Andrerizm/IoTMaintenanceDWD/dashboard/assets/hero-bg.png

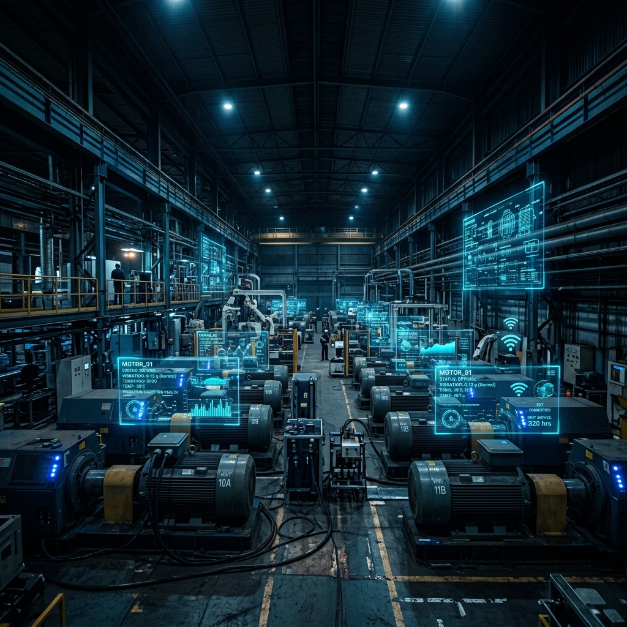
dashboard/assets/hero-bg.png
