Andrerizm/IoTMaintenanceDWD/Flowchart.png

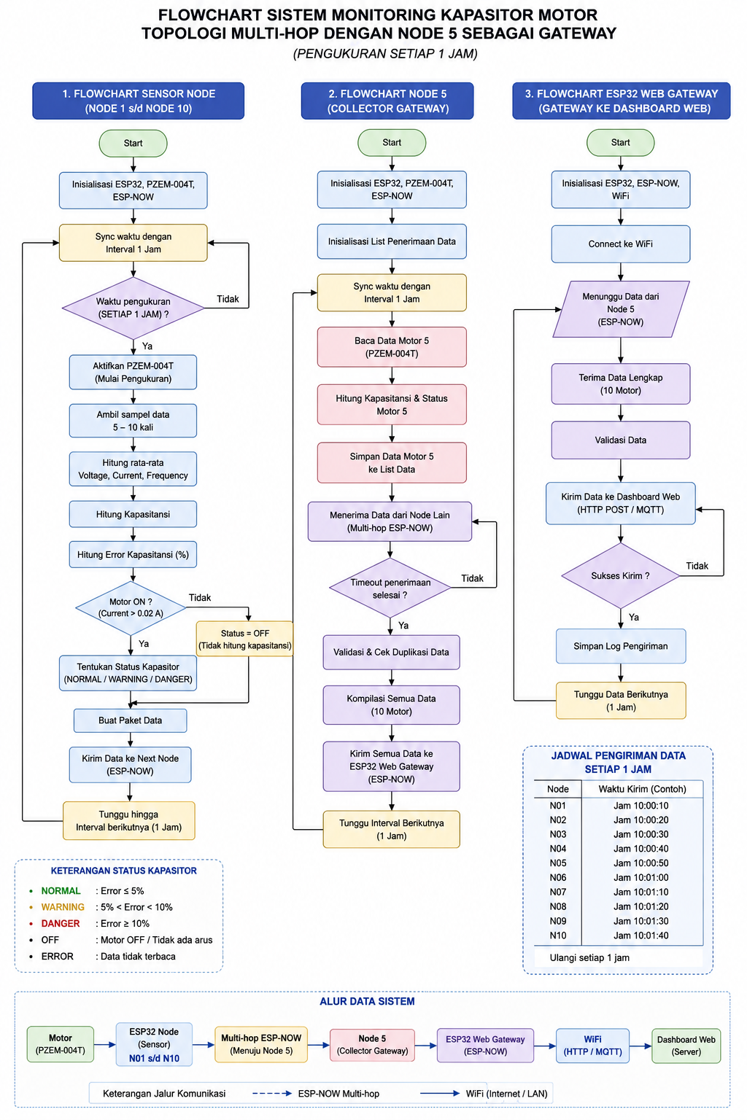
Flowchart.png
