Andrerizm/IoTMaintenanceDWD/PPT/Perbandingan Wireless dan Wired Pada Monitoring Kapasitor.pptx

## Perbandingan Topologi Wired vs Wireless

- Komparasi Arsitektur | Wired RS485 vs Wireless ESP-NOW

- Andre Rizkyna Muharam

- Sistem Monitoring Kapasitansi Kapasitor Motor

## Slide 2

IN THIS REPORT

Latar Belakang

- Efisiensi biaya sistem monitoring
- Kondisi mesin memanjang

Opsi Wired

- 1 ESP32 pusat
- 10 PZEM melalui bus RS485

Opsi Wireless

- 10 ESP32 node untuk 10 motor
- ESP-NOW / WiFi lokal

Perbandingan

- Komponen, biaya, stabilitas
- Risiko dan maintenance

Rekomendasi

Untuk mesin memanjang dan efisiensi biaya, opsi wired RS485 lebih disarankan.

2

## Slide 3

KONFIGURASI YANG
DIBANDINGKAN

3

## Slide 4

OPSI 1: WIRELESS

- 1 motor = 1 PZEM + 1 ESP32.
- Setiap node mengirim data melalui ESP-NOW/WiFi.
- Kabel komunikasi antar motor tidak diperlukan.
- Cocok jika penarikan kabel sangat sulit.

OPSI 2: WIRED RS485

- 10 PZEM dihubungkan ke 1 ESP32 pusat melalui bus RS485.
- Setiap PZEM diberi alamat berbeda.
- Topologi daisy-chain mengikuti mesin memanjang.
- ESP32 pusat mengirim data ke dashboard.

Fokus Keputusan

Biaya & Stabilitas

4

## Slide 5

METODOLOGI PENGUKURAN KAPASITANSI

3

## Slide 6

PRINSIP PERHITUNGAN

CONTOH UNTUK 2 UF / 220 VAC

I = 2 pi x 50 x 2e-6 x 220
I ≈ 0,138 A

- Karena arus kapasitor kecil, sensor arus harus memiliki range kecil dan resolusi cukup.
- CT harus dipasang pada satu kabel kapasitor, bukan kabel utama motor.
- Voltage transducer membaca terminal kapasitor, bukan hanya sumber utama.

C = I / (2 pi x f x V)

- I = arus RMS pada jalur kapasitor dari CT clamp.
- V = tegangan RMS pada terminal kapasitor dari voltage transducer.
- f = frekuensi listrik, digunakan 50 Hz.
- Hasil C dikonversi ke mikrofarad untuk dashboard.

Kapasitor
2 uF

CT Clamp
I RMS

Voltage
Transducer

ESP32
Hitung C

Dashboard

6

## Slide 7

PERBANDINGAN KOMPONEN
PER MESIN

5

## Slide 8

RINGKASAN PERBANDINGAN

Aspek | Wireless | Wired RS485
ESP32 per mesin | 10 pcs | 1 pcs
Komunikasi | ESP-NOW/WiFi antar node | RS485 daisy-chain
Power Supply | Satu PSU per node | Satu PSU 5V 5A untuk semua node
Instalasi | Lebih mudah karena sedikit kabel | Lebih banyak pemasangan kabel
Perawatan | Setiap node berdiri sendiri | Pemeriksaan bus dan koneksi terminal
Resiko gangguan | Sinyal wireless dapat terhalang struktur mesin dan mengganggu jaringan mesh | Kabel dapat putus atau koneksi terminal longgar
Paling cocok | Lokasi sulit dijangkau kabel | Mesin memanjang dan membutuhkan komunikasi yang stabil
Stabilitas Komunikasi | Dipengaruhi jarak, penghalang, dan interfensi | Lebih stabil pada lingkungan industry
Harga | Rp4.496.750 - Rp5.053.750 | Rp1.478.139 – Rp1.674.139

RS485

11 conv.

10 sisi PZEM + 1 sisi controller.

Wired

1 ESP32

Satu controller pusat membaca 10 PZEM.

Wireless

10 ESP32

Satu node mandiri untuk setiap motor.

Skala

30 mesin

Wired mengurangi ESP32 dari 300 menjadi 30 unit.

6

## Slide 9

PERBANDINGAN TEKNIS

7

## Slide 10

WIRELESS

WIRED RS485

10 node ESP32

- Koneksi komunikasi antar motor tidak memakai kabel.
- Setiap titik membutuhkan ESP32, power, box, dan konfigurasi node.
- Dipengaruhi posisi antena, panel logam, dan noise 2,4 GHz.

1 controller pusat + bus data

- Lebih stabil untuk mesin memanjang.
- Biaya controller lebih rendah.
- Perlu kabel twisted pair, terminasi, alamat PZEM, dan proteksi jalur.

PZEM
Motor

TTL-RS485
Node

RS485
Bus

ESP32
Pusat

Dashboard
Web

8

## Slide 11

ANALISIS RISIKO
DAN MITIGASI

9

## Slide 12

1
Power
5 V

2
Jarak
Mesin

3
Noise
Motor

4
Alamat
PZEM

5
Bus
RS485

6
Data ke
Dashboard

RISIKO OPSI WIRELESS

- Sinyal ESP-NOW dapat terganggu panel logam.
- Setiap motor membutuhkan ESP32 dan supply sendiri.
- Konfigurasi node lebih banyak.
- Troubleshooting tersebar di 10 titik.
- Rawan mengganggu sinyal komunikasi lain

RISIKO OPSI WIRED

- Kabel bus harus ditarik sepanjang mesin.
- Jika bus putus, node setelah titik putus dapat terganggu (bisa diakali dengan mengubah system pengkabelan).
- Perlu terminasi 120 ohm di dua ujung dan alamat unik.
- Distribusi 5 V harus memperhatikan drop tegangan.

10

## Slide 13

WIRING DIAGRAM

9

## Slide 14

WIRELESS

9

## Slide 15

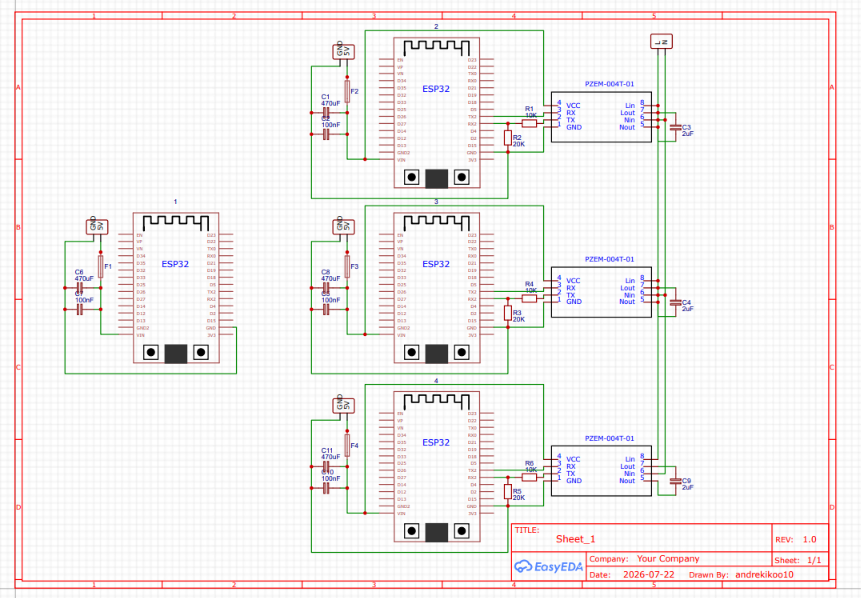
[picture p6: figure]

## Slide 16

WIRED

9

## Slide 17

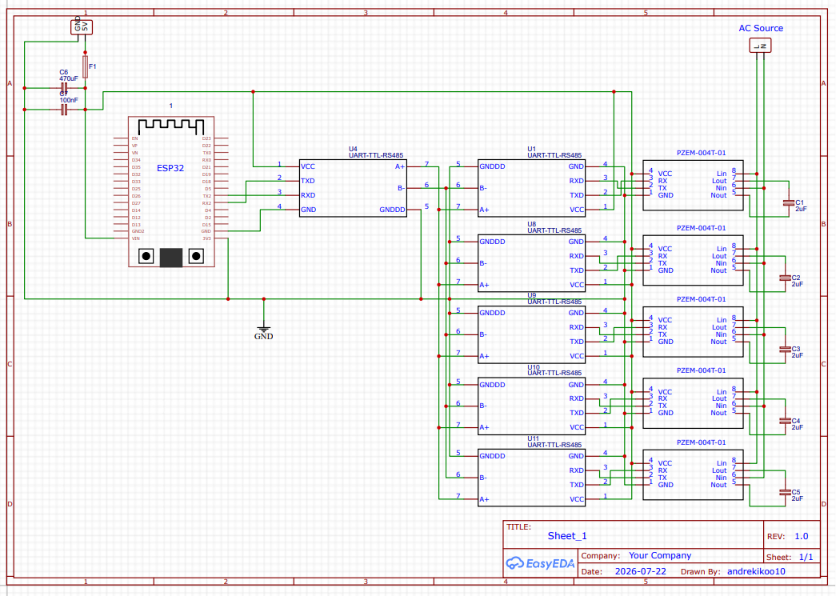
[picture p7: figure]

## Slide 18

REKOMENDASI
AKHIR

11

## Slide 19

Titik Motor

Motor 01 - 30
Kapasitor

Node Meter

PZEM-004T
Alamat 0x01

Bus Komunikasi

Dashboard

Dashboard
Historis

TTL-RS485
Auto Direction

ESP32 Pusat
Polling 1 Jam

REKOMENDASI

Menggunakan wired RS485 sebagai backbone pada mesin memanjang, lalu menggunakan wireless hanya dari ESP32 pusat ke dashboard/server. Opsi ini menekan biaya ESP32, lebih stabil terhadap panel logam, dan tetap mendukung data historis setiap motor.

12

## Slide 20

DASHBOARD WEB MONITORING

3

## Slide 21

TAMPILAN GRID 30 MESIN

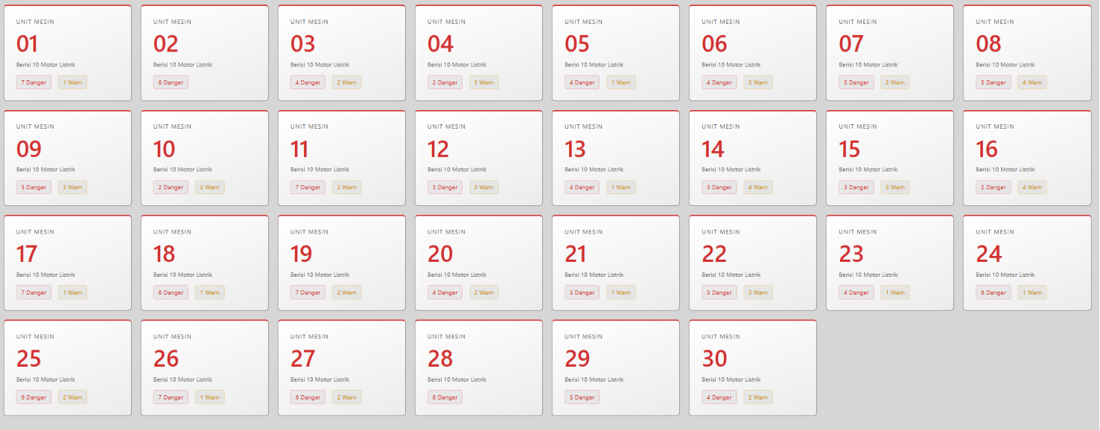
[picture p8: figure]

10

## Slide 22

SAAT KOTAK MESIN DITEKAN

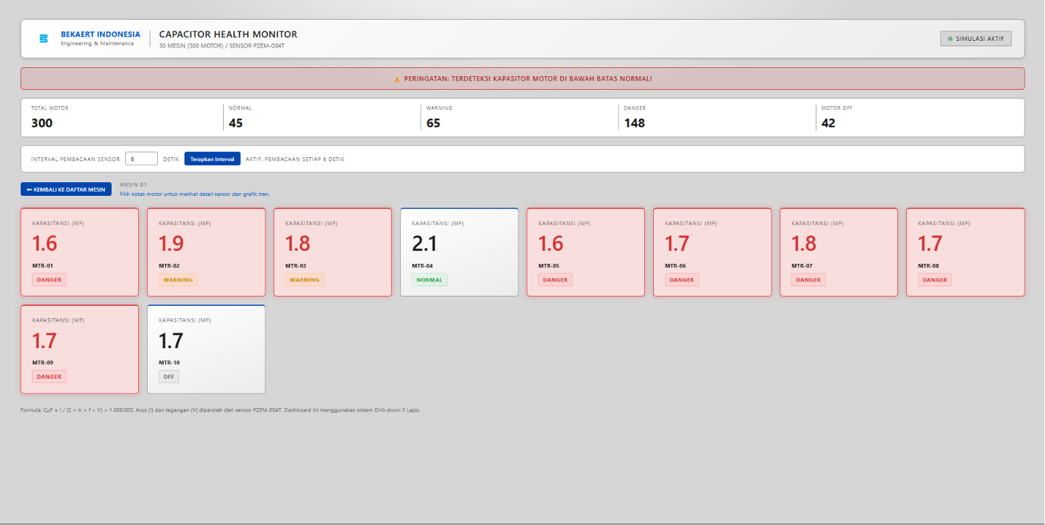
[picture p9: figure]

11

## Slide 23

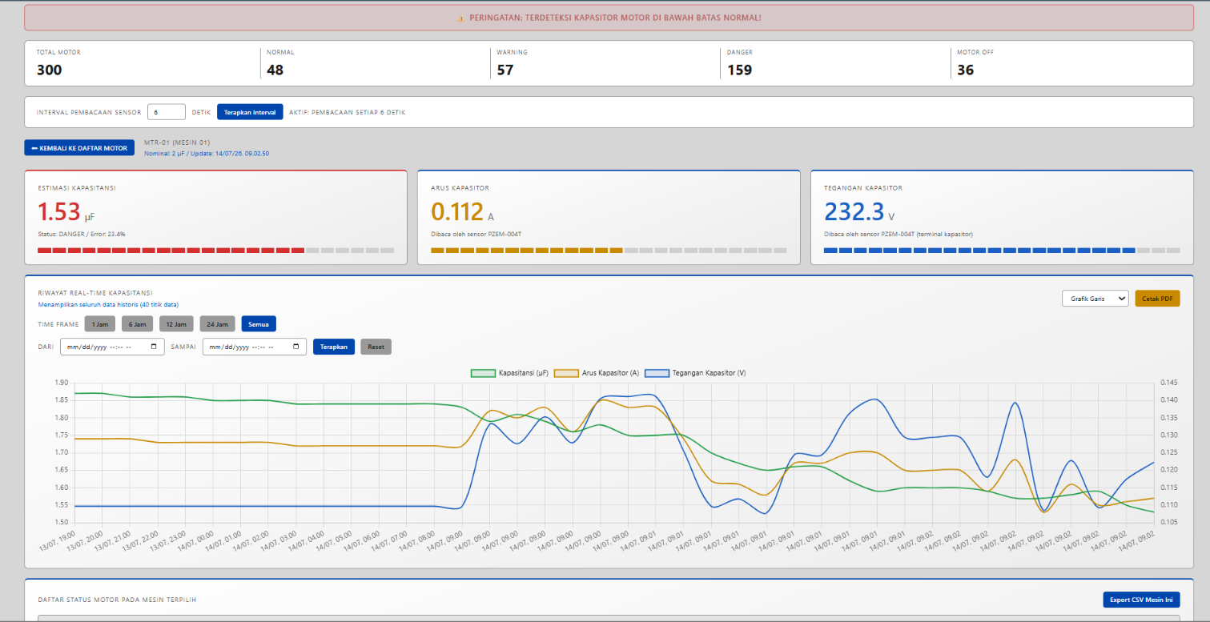
[picture p10: figure]

SAAT KOTAK MOTOR DITEKAN

12

## Slide 24

PERBANDINGAN HARGA DAN KOMPONEN YANG DIGUNAKAN

9

## Slide 25

WIRELESS

9

## Slide 26

WIRELESS

No | Komponen | Fungsi | Kuantitas | Harga Satuan | Total Harga | Link
1 | ESP32 DevKit V1 | Controller utama, hitung C, kirim data dashboard | 10 pcs | Rp63.000 – Rp100.000 | Rp630.000 - Rp1000.000 | Produk (https://www.tokopedia.com/rajaduino/esp32-esp-32-devkit-v1-board-30-pin-wifi-bluetooth-ble-microcontroller-cp2102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)
2 | PZEM-004T 10A | Membaca arus, tegangan, frekuensi, power factor, dan daya tiap kapasitor | 10 pcs | Rp65.000 - Rp80.000 | Rp650.000 - Rp800.000 | Produk (https://www.tokopedia.com/automa88/pzem-004t-10a-multifunction-ac-220v-volt-ampere-energy-meter-10a-ttl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)
3 | ESP32 Web Gateway | Diperlukan jika gateway web dipisahkan | 1 pcs | Rp63.000 – Rp100.000 | Rp63.000 – Rp100.000 | Produk (https://www.tokopedia.com/rajaduino/esp32-esp-32-devkit-v1-board-30-pin-wifi-bluetooth-ble-microcontroller-cp2102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)
4 | PCB matrix | Pengaman tata letak komponen di titik | 11 pcs | Rp15.000 | Rp150.000 | Produk (https://shopee.co.id/PCB-Dot-Matrix-Thru-Hole-Single-Layer-9x15-cm-%E2%80%93-Papan-Prototyping-Elektronik-i.62956347.5413059604)
5 | Box | Sebagai pengaman kompoen dan PCB | 11 pcs | Rp12.000 | Rp132.000 | Produk (https://shopee.co.id/BOX-MULTI-BOX-PLASTIK-SERBAGUNA-BOX-PROJEK-X1-X2-X3-X4-X5-X6-BELUM-TERMASUK-BAUT-i.395114462.25014973652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)
6 | PSU Omron 5 VDC | Input daya untuk semua komponen | 11 pcs | Rp258.000 | Rp2.838.000 | Produk (https://www.tokopedia.com/kse/power-supply-omron-s8fs-c03505-asli-output-5vdc-7-0a?t_id=1784100296235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)
7 | Fuse setiap node | Pengaman semua komponen Listrik | 11 pcs | Rp350 | Rp3.850 | Produk (https://shopee.co.id/FUSE-TABUNG-KACA-5X20MM-SEKRING-GLASS-FUSE-0.5A-1A-2A-5A-10A-20A-30A-READY-BERBAGAI-AMPERE-i.30189058.45560310263)
8 | Resistor pembagi tegangan 10k | Untuk membagi tegangan sinyal dari PZEM-004T ke ESP32 | 10 pcs | Rp390 | Rp3.900 | Produk (https://shopee.co.id/Isi-10Pcs-Resistor-10k-i.158052110.23979162444)
9 | Resistor pembagi tegangan 20k | Untuk membagi tegangan sinyal dari PZEM-004T ke ESP32 | 10 pcs | Rp200 | Rp2.000 | Produk (https://shopee.co.id/resistor-1-4-watt-1-4W-0.25w-0.25-W-200-2K-20K-OHM-i.59464640.44753998682)

## Slide 27

WIRELESS

No | Komponen | Fungsi | Kuantitas | Harga Satuan | Total Harga | Link
10 | Resistor pembagi tegangan 20k | Untuk membagi tegangan sinyal dari PZEM-004T ke ESP32 | 10 pcs | Rp200 | Rp2.000 | Produk (https://shopee.co.id/resistor-1-4-watt-1-4W-0.25w-0.25-W-200-2K-20K-OHM-i.59464640.44753998682)
11 | Fuse Holder 5x20mm | Holder untuk fuse pada setiap PCB | 11 pcs | Rp2.000 | Rp22.000 | Produk (https://shopee.co.id/Fuse-Holder-PCB-Soket-Fuse-kaca-PCB-Rumah-Fuse-Terminal-Sekring-Kaca-untuk-2cm-i.1009900261.27381709768)

Total Harga
Rp4.496.750 - Rp5.053.750

## Slide 28

WIRED

9

## Slide 29

No | Komponen | Fungsi | Kuantitas | Harga Satuan | Total Harga | Link
1 | ESP32 DevKit V1 | Controller utama, hitung C, kirim data dashboard | 1 pcs | Rp63.000 – Rp100.000 | Rp63.000 – Rp100.000 | Produk (https://www.tokopedia.com/hwthinker/esp32-esp-32-doit-devkit-v1-30-pin-wifi-bluetooth-ble-dual-core-board-esp32-cp2102-88a25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)
2 | PZEM-004T 10A | Membaca arus, tegangan, frekuensi, power factor, dan daya tiap kapasitor | 10 pcs | Rp65.000 - Rp80.000 | Rp650.000 - Rp800.000 | Produk (https://www.tokopedia.com/automa88/pzem-004t-10a-multifunction-ac-220v-volt-ampere-energy-meter-10a-ttl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)
3 | TTL-to-RS485 auto-direction | Converter dari UART ke RS485 | 11 pcs | Rp6.199 | Rp68.189 | Produk (https://shopee.co.id/Modul-Converter-Serial-TTL-to-RS485-Module-RX-TX-485-to-Serial-UART-Level-Mutual-Conversion-Hardware-Automatic-Flow-Control-3.3V-5.5V-i.1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)
4 | PSU Omron 5VDC | Supply utama pada semua komponen | 1 pcs | Rp258.000 | Rp258.000 | Produk (https://www.tokopedia.com/kse/power-supply-omron-s8fs-c03505-asli-output-5vdc-7-0a?t_id=1784100296235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)
5 | Fuse utama 3.15 A | Melindungi semua komponen dari lonjakan listrik | 1 pcs | Rp350 | Rp3.500 | Produk (https://shopee.co.id/FUSE-TABUNG-KACA-5X20MM-SEKRING-GLASS-FUSE-0.5A-1A-2A-5A-10A-20A-30A-READY-BERBAGAI-AMPERE-i.30189058.45560310263)
7 | Resistor terminasi 120 Ω | Mencegah pantulan sinyal | 2 pcs | Rp250 | Rp2.500 | Produk (https://shopee.co.id/Resistor-1-4W-Metal-Film-1-R-100-120-150-200-220-270-330-390-470-560-680-820-Ohm-1-4-W-Watt-i.342972164.16798892953)
8 | PCB matrix | Menjaga tata letak setiap komponen | 11 pcs | Rp15.000 | Rp150.000 | Produk (https://shopee.co.id/PCB-Dot-Matrix-Thru-Hole-Single-Layer-9x15-cm-%E2%80%93-Papan-Prototyping-Elektronik-i.62956347.5413059604)
9 | Kapasitor 100nF | Menyaring noise frekuensi Tinggi | 11 pcs | Rp1000 | Rp11.000 | Produk (https://shopee.co.id/Capacitor-keramik-100nF-50V-104-50Volt-i.44140220.11350442580)
10 | Kapasitor 100uF | Menahan drop tegangan lokal | 10 pcs | Rp1000 | Rp10.000 | Produk (https://shopee.co.id/Kapasitor-Capacitor-ELCO-100uf-50v-100-uf-50-v-100uf-50v-Elko-100uF-50V-i.783660429.23919516606)
11 | Kapasitor 470 µF controller | Menahan lonjakan arus ESP32 | 10 pcs | Rp1.300 | Rp13.000 | Produk (https://shopee.co.id/(-5-BUAH-)-CAPACITOR-ELCO-25V-470UF-105%C2%B0C-RANDOM-i.212427364.17961281486)

## Slide 30

No | Komponen | Fungsi | Kuantitas | Harga Satuan | Total Harga | Link
12 | Box | Sebagai pengaman kompoen dan PCB | 11 pcs | Rp12.000 | Rp132.000 | Produk (https://shopee.co.id/BOX-MULTI-BOX-PLASTIK-SERBAGUNA-BOX-PROJEK-X1-X2-X3-X4-X5-X6-BELUM-TERMASUK-BAUT-i.395114462.25014973652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)
13 | Terminal blok 3 pin | Input dari UART ke RS485 | 11 pcs | Rp5.000 | Rp55.000 | Produk (https://shopee.co.id/Terminal-Blok-Hijau-KF2EDG-5.08mm-2pin-3pin-4pin-5pin-Model-L-Terminal-Block-KF2EDG-Konektor-2EDG-Siku-2-Kaki-3-Kaki-4-Kaki-5-Kaki-Lurus-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)
14 | Terminal blok 2 pin | Input daya pada semua komponen | 11 pcs | Rp4.450 | Rp48.950 | Produk (https://shopee.co.id/Terminal-Blok-Hijau-KF2EDG-5.08mm-2pin-3pin-4pin-5pin-Model-L-Terminal-Block-KF2EDG-Konektor-2EDG-Siku-2-Kaki-3-Kaki-4-Kaki-5-Kaki-Lurus-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)
15 | Fuse Holder 5x20mm | Holder untuk fuse pada setiap PCB | 11 pcs | Rp2.000 | Rp22.000 | Produk (https://shopee.co.id/Fuse-Holder-PCB-Soket-Fuse-kaca-PCB-Rumah-Fuse-Terminal-Sekring-Kaca-untuk-2cm-i.1009900261.27381709768)
16 | Skun ferrules warna merah, hitam, kuning, biru | Merapihkan kabel yang akan masuk ke terminal blok | Masing – masing 25 pcs | Rp225 | Rp22.500 | Produk (https://shopee.co.id/SKUN-FERRULES-SKUN-KABEL-TUSUK-E0508-E7508-E1508-E1008-E2508-E4010-i.62956347.29058589040)

Total Harga
Rp1.478.139 – Rp1.674.139
