Andrerizm/IoTMaintenanceDWD/PPT/Sistem_Monitoring_Kapasitor_Motor_PZEM004T_Revisi.pptx

## Sistem Monitoring Kapasitansi Kapasitor Motor

- Berbasis ESP32 | PZEM-004T | 220 VAC | Kapasitor 2 uF

- Andre Rizkyna Muharam

- Studi Kasus: Mesin CA, PT Bekaert

## Slide 2

IN THIS REPORT

Latar Belakang

- Kondisi kapasitor motor
- Peluang preventive maintenance

Metode Pengukuran

- 220 VAC, 50 Hz
- PZEM-004T digital meter

Tujuan & Ruang Lingkup

- Monitoring otomatis
- Studi kasus mesin CA

Sistem & Komponen

- ESP32, PZEM-004T, CD74HC4067
- Dashboard web dan data historis

Highlight

Kapasitor nominal 2 uF, 220 VAC, warning >5%, danger >=10%, pembacaan digital tanpa ADC.

2

## Slide 3

LATAR BELAKANG DAN TUJUAN

3

## Slide 4

LATAR BELAKANG

- Kapasitor motor berpengaruh terhadap starting, torsi awal, dan stabilitas operasi motor AC.
- Nilai kapasitansi dapat menurun akibat panas, penuaan dielektrik, dan siklus operasi berat.
- Mesin CA memiliki siklus ON/OFF, sehingga data historis dapat dimanfaatkan untuk maintenance.

TUJUAN PROJECT

- Merancang sistem monitoring kapasitansi otomatis berbasis ESP32.
- Membaca arus, tegangan, dan frekuensi secara digital menggunakan PZEM-004T.
- Menghindari penggunaan ADC eksternal dan sensor analog agar wiring lebih sederhana.
- Menampilkan status kapasitor dan tren historis melalui dashboard web lokal.

Output Utama

Dashboard

4

## Slide 5

SPESIFIKASI SISTEM YANG DIREVISI

3

## Slide 6

Tegangan Kerja

220 VAC

Pengukuran dilakukan pada terminal kapasitor/motor sesuai data terbaru.

Kapasitor

2 uF

Nilai nominal kapasitor yang digunakan pada mesin.

Frekuensi

50 Hz

Frekuensi listrik untuk perhitungan kapasitansi.

Jumlah Motor

10 / mesin

Prototype membaca 10 motor per mesin; total target 30 mesin = 300 motor.

BATAS STATUS KAPASITOR

Status | Error | Rentang kapasitansi
Normal | <= 5% | 1,90 - 2,10 uF
Warning | > 5% | <1,90 uF atau >2,10 uF
Danger | >= 10% | <1,80 uF atau >2,20 uF

CATATAN REVISI

- Konsep sensor analog CT/VT + ADC direvisi menjadi pembacaan digital PZEM-004T.
- Sistem tidak lagi menggunakan ADS1115, TCA9548A, atau filter analog.
- PZEM-004T 10A membaca tegangan, arus, dan frekuensi tiap kapasitor.
- Untuk 10 motor digunakan 2 CD74HC4067 sebagai multiplexer jalur TX/RX.

5

## Slide 7

METODOLOGI PENGUKURAN KAPASITANSI

3

## Slide 8

PRINSIP PERHITUNGAN

CONTOH UNTUK 2 UF / 220 VAC

I = 2 pi x 50 x 2e-6 x 220
I ≈ 0,138 A

C = I / (2 pi x f x V)

- I = arus RMS kapasitor dari PZEM-004T.
- V = tegangan RMS terminal kapasitor dari PZEM-004T.
- f = frekuensi listrik dari PZEM-004T, umumnya 50 Hz.
- ESP32 menghitung C dan mengirim hasil ke dashboard.

- Arus kapasitor 2 uF sekitar 0,138 A pada 220 VAC.
- PZEM-004T 10A dipilih karena output digital dan tidak memerlukan ADC.
- Setiap motor menggunakan 1 PZEM-004T.
- Pembacaan 10 PZEM dilakukan bergantian melalui multiplexer serial.

Kapasitor
2 uF

PZEM-004T
I, V, f

CD74HC4067
TX/RX Mux

ESP32
Hitung C

Dashboard

6

## Slide 9

ALUR AKUISISI DATA PER SIKLUS

3

## Slide 10

1
Pilih
PZEM

2
Baca
Data Digital

3
Ambil
I, V, f

4
Hitung
C uF

5
Bandingkan
Threshold

6
Kirim ke
Dashboard

STATE MACHINE

- WAIT: sistem menunggu jadwal sampling dan memilih motor.
- SELECT: ESP32 memilih channel PZEM melalui CD74HC4067.
- READ: ESP32 membaca data digital arus, tegangan, dan frekuensi.
- CALCULATE: kapasitansi dihitung dan disimpan bersama timestamp.

KEAMANAN PEMBACAAN

- ESP32 tidak terhubung langsung ke 220 VAC.
- PZEM-004T membaca data listrik dan mengirim data digital TTL.
- Jalur TX PZEM ke RX ESP32 diberi level shifter/pembagi tegangan.
- Fuse, terminal block, dan enclosure digunakan pada sisi panel.

7

## Slide 11

ARSITEKTUR SISTEM

3

## Slide 12

Tidak ada koneksi langsung antara ESP32 dan 220 VAC. Data listrik dibaca oleh PZEM-004T sebagai data digital, dipilih melalui multiplexer CD74HC4067, lalu diproses oleh ESP32 untuk dashboard.

Zona Tegangan 220 VAC

Motor 01
Kapasitor 2 uF

Kontrol & Multiplexer

Data & Visualisasi

Database +
Dashboard

Meter Digital

PZEM-004T
I/V/f digital

CD74HC4067
TX/RX Mux

ESP32
WiFi

Motor 02
Kapasitor 2 uF

PZEM-004T
I/V/f digital

CD74HC4067
TX/RX Mux

ESP32
WiFi

Database +
Dashboard

Motor ... 10
Kapasitor 2 uF

PRINSIP UTAMA

PZEM-004T
I/V/f digital

CD74HC4067
TX/RX Mux

ESP32
WiFi

Database +
Dashboard

8

## Slide 13

DAFTAR KOMPONEN UTAMA PER MESIN

3

## Slide 14

No | Komponen | Fungsi | Kuantitas | Harga Satuan | Total Harga | Link
1 | ESP32 DevKit V1 | Controller utama, hitung C, kirim data dashboard | 1 pcs | Rp63.000 – Rp100.000 | Rp100.000 | https://www.tokopedia.com/rajaduino/esp32-esp-32-devkit-v1-board-30-pin-wifi-bluetooth-ble-microcontroller-cp2102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
2 | PZEM-004T 10A | Membaca arus, tegangan, frekuensi, power factor, dan daya tiap kapasitor | 10 pcs | Rp65.000 - Rp80.000 | Rp650.000 - Rp800.000 | https://www.tokopedia.com/automa88/pzem-004t-10a-multifunction-ac-220v-volt-ampere-energy-meter-10a-ttl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
3 | CD74HC4067 | Multiplexer serial jalur TX dan RX PZEM | 2 pcs | Rp15.000 | Rp30.000 | https://www.tokopedia.com/solarperfect/cd74hc4067-16-channel-analog-digital-multiplexer-1730816060399387932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

9

## Slide 15

No | Komponen | Fungsi | Kuantitas | Harga Satuan | Total Harga | Link
5 | Fuse input power supply 250 VAC 0,5A - 1A | Melindungi power supply 5V dari short atau arus lebih | 1 pcs | Rp12.500 | Rp12.500 | https://www.tokopedia.com/automa88/fuse-tabung-keramik-5x20mm-0-25a-1a-2-5a-3a-3-15a-6a-7a-8a-12a-250v-1a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
7 | Power supply 5V 5A | Supply ESP32, PZEM, multiplexer, dan rangkaian kontrol | 1 pcs | Rp50.000 – Rp100.000 | Rp100.000 | https://www.tokopedia.com/yyelectronik/power-supply-psu-5v-witching-body-kecil-5a-10a-5v-5a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

9

## Slide 16

DASHBOARD WEB MONITORING

3

## Slide 17

TAMPILAN GRID 30 MESIN


10

## Slide 18

SAAT KOTAK MESIN DITEKAN


11

## Slide 19


SAAT KOTAK MOTOR DITEKAN

12

## Slide 20

RENCANA IMPLEMENTASI & OUTPUT

3

## Slide 21

TAHAPAN IMPLEMENTASI

Validasi titik ukur 220 VAC

OUTPUT YANG DIHARAPKAN

- Nilai kapasitansi tiap motor dalam satuan uF.
- Status Normal / Warning / Danger berdasarkan 2 uF dengan batas 5% dan 10%.
- Data historis untuk preventive/predictive maintenance.
- Dashboard lokal yang dapat dipantau oleh tim maintenance.
- Prototype tanpa ADC eksternal karena data PZEM sudah digital.

1

2

Pemasangan PZEM-004T 10A

3

Firmware ESP32 + multiplexer TX/RX

4

Database + dashboard web

5

Uji multi-PZEM dan alarm lapangan

Benefit

Downtime turun

11
