Andrerizm/IoTMaintenanceDWD/RAB Project Monitoring Kapasitor.xlsx

Harga Untuk 1 Mesin
No. | Komponen | Spesifikasi yang disarankan | Jumlah | Fungsi | Link
1 | ESP32 DevKit V1 | ESP32-WROOM-32, 30 pin | 1 pcs | Controller pusat dan pengirim data | Produk (https://www.tokopedia.com/rajaduino/esp32-esp-32-devkit-v1-board-30-pin-wifi-bluetooth-ble-microcontroller-cp2102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)
2 | PZEM-004T V3 | Versi 10 A, built-in shunt, UART TTL | 10 pcs | Mengukur tegangan, arus, daya, frekuensi, dan energi setiap motor | Produk (https://www.tokopedia.com/automa88/pzem-004t-10a-multifunction-ac-220v-volt-ampere-energy-meter-10a-ttl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)
3 | TTL to RS485 auto-direction | Supply 3,3–5 V, hardware automatic flow control | 11 pcs | Konversi UART TTL menjadi RS485 | Produk (https://shopee.co.id/product/173966459/14048703162)
4 | Power supply | Input 220 VAC, output 5 VDC 5 A, industrial | 1 pcs | Sumber daya utama sepanjang mesin | Produk (https://shopee.co.id/Power-Supply-5V-5A-Body-Kecil-i.24440184.2677009917)
5 | Fuse utama 5 V | T3A slow-blow, 5 × 20 mm | 1 pcs | Menurunkan 24 V menjadi 5 V di setiap titik | Produk (https://www.tokopedia.com/automa88/fuse-tabung-keramik-5x20mm-0-25a-1a-2-5a-3a-3-15a-6a-7a-8a-12a-250v-1a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)
6 | Fuse holder | Untuk fuse 5 × 20 mm, through-hole/panel | 1 pcs | Terminasi di kedua ujung fisik bus RS485 | Produk (https://www.tokopedia.com/arieselektronikstore/10-pcs-fuse-holder-pcb-bijian-1731057648435889810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)
7 | Resettable fuse cabang | PTC sekitar 0,3–0,5 A per node | 10 pcs | Tempat rangkaian pusat | Produk
8 | Resistor terminasi RS485 | 120 Ω, ¼ W | 2 pcs | Tempat rangkaian pada setiap motor | Produk
