Andrerizm/IoTMaintenanceDWD/Wiring Wired.pdf

## AC Source

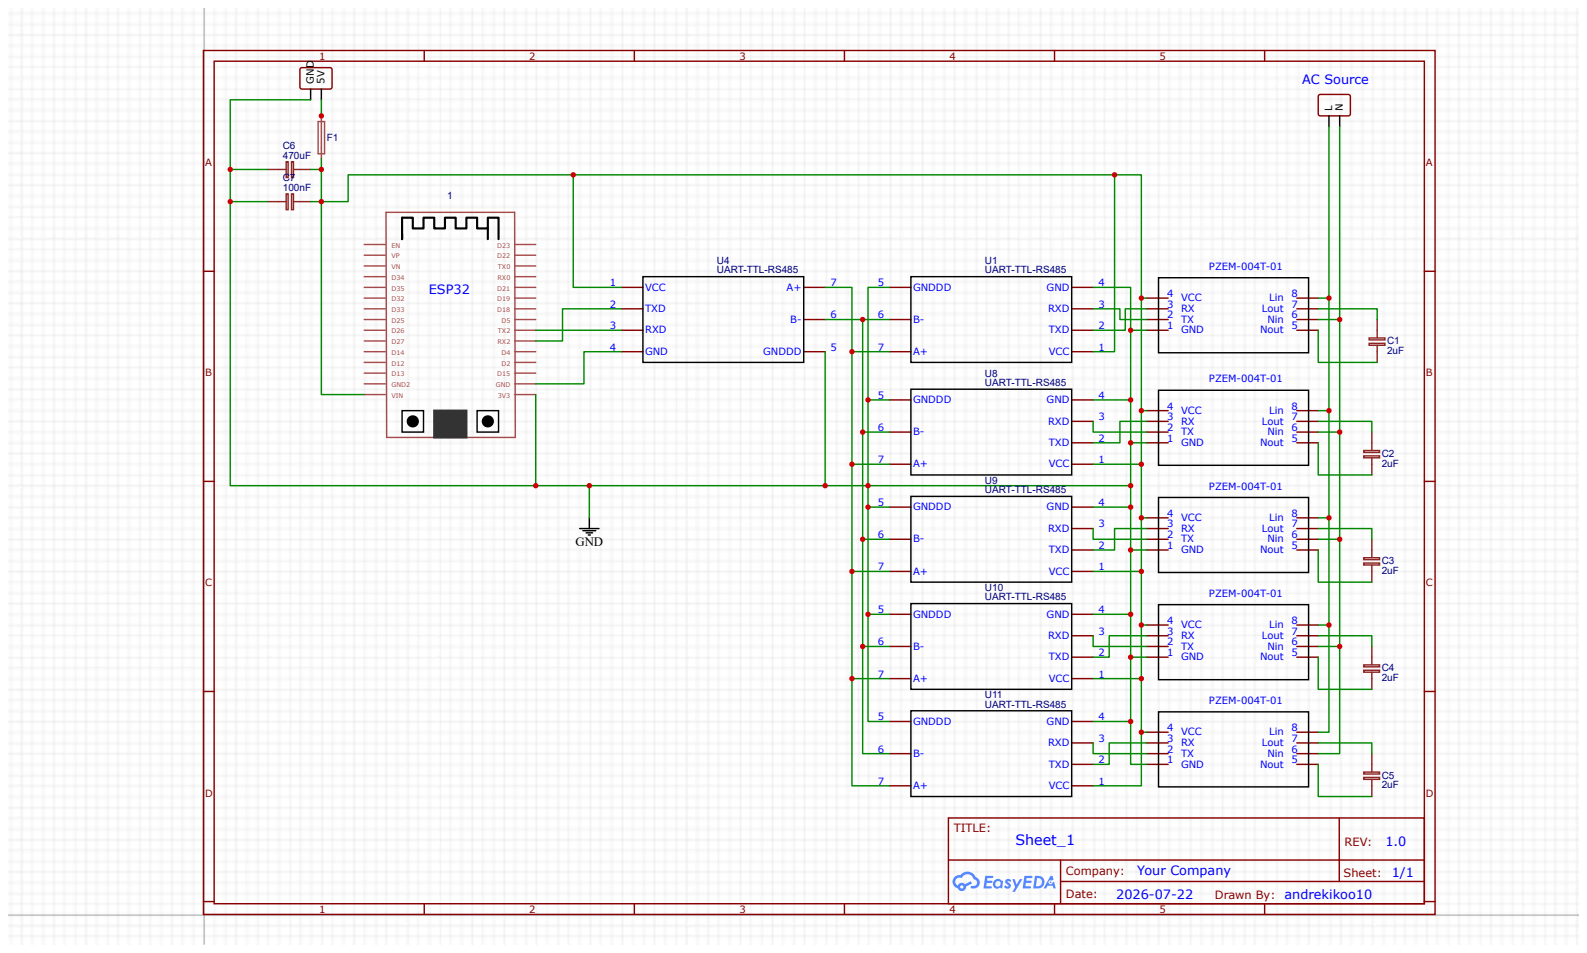
[picture p16: page 1]
