Andrerizm/IoTMaintenanceDWD/Wiring Wireless.pdf

A

A

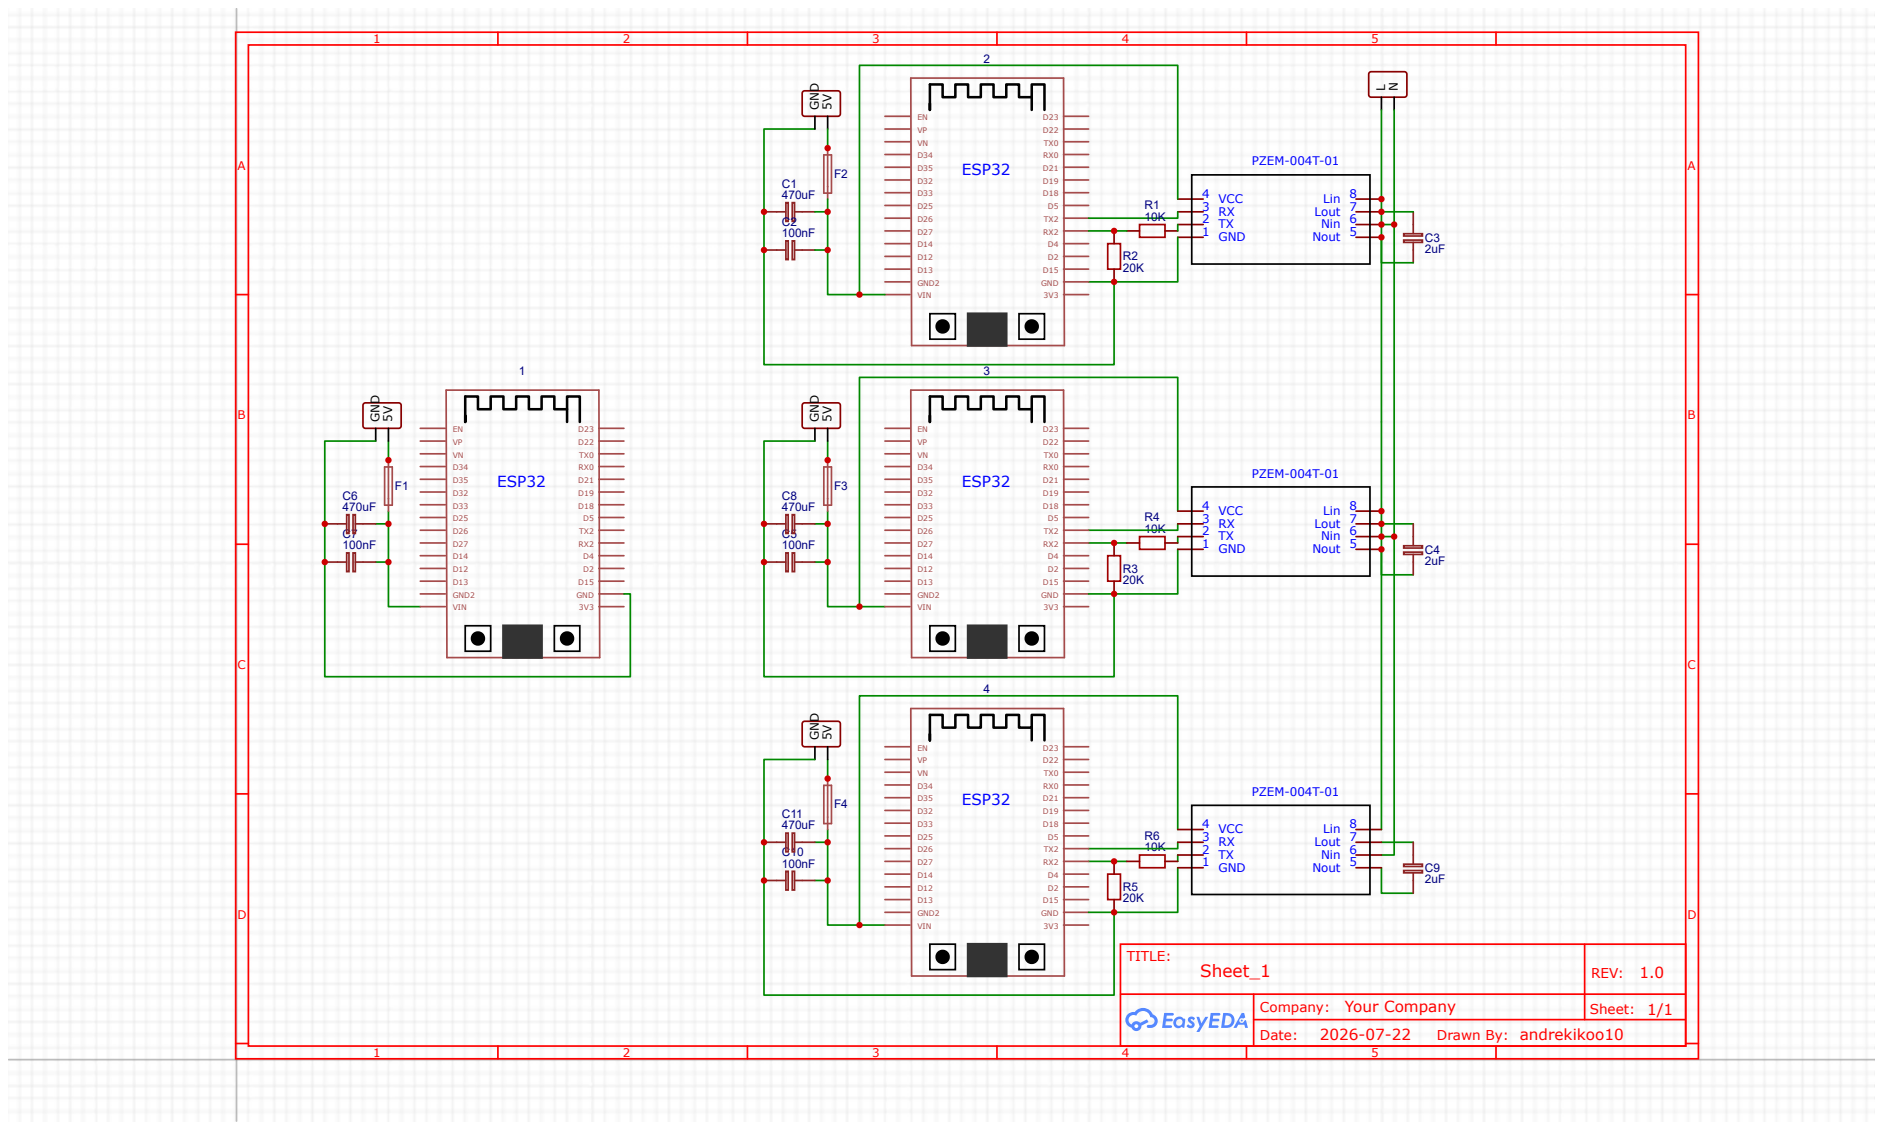
[picture p17: page 1]
