Andrerizm/IoTMaintenanceDWD/(commit log)

2026-09-04 feat: initial commit for IoT Motor Capacitor Monitoring System
    [RAB Project Monitoring Kapasitor.xlsx]
2026-09-07 Update theme to Motor Stirrer Monitoring System, translate READMEs to English, and streamline login UI
